HACKCLUBGANG/Per-Key-Rgb-Keyboard-Hotswap-FORGE/README.md

# Per-Key-Led-Keyboard-Hotswap-FORGE

Source Link Onshape -  https://cad.onshape.com/documents/a3706bff300e93766397b60f/w/be6071b581e0c225a171638b/e/79bd546bad59e5e5cdb5a4cd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
---------------------------------------
Render

Onshape


This is the Per-Key-Led-Keyboard-Hotswap which says in its name that it has per key ice blue led
It also has kailh hotswap attachment so u can also switch keys without worrying about opening the keyboard
Each key has a south facing smd ice blue led under the switch.


Heres A Render Of The Whole Build

https://github.com/user-attachments/assets/ba00d72b-443f-43d3-ab56-3a87e9c14a67

# Features 
- Per Key Rgb Customizable
- Hotswappable
- Compact  60%  10.1cm X 29.2 cm
- Usb C Powered
- 3d Printed Case
- Rp Pi Pico Fitted Into A Compact Keyboard
- 2 Layer Pcb
- Custom Made Led Circuitry
 Cool Looking :>

# Schematics 
Files in /PcbandSchem






#  Printed Circuit Board PCB
Files in /PcbandSchem

Front  Copper 

Back Copper

Both Layers


# Cad
Files in /CAD
Bottom   Plate

Top Plate

Both


# BOM
| # | Component | Part Number / Model | Qty Needed | Qty Purchased | Price (INR) | Product Link |
|---:|---|---|---:|---:|---:|---|
| 1 | Custom PCB + Shipping | JLCPCB FR-4 | 1 | 1 | ~2665 | [JLCPCB](https://jlcpcb.com/) |
| 2 | Microcontroller | Raspberry Pi Pico (RP2040) | 1 | 1 | 422 | [Robu](https://robu.in/) |
| 3 | USB-C Female Connector | Hroparts TYPE-C-31-M-13A (R250302) | 1 | 1 | 27 | [Robu](https://robu.in/product/type-c-31-m-13a-hroparts-5a-1-recessed-mount-16p-female-30%e2%84%8380-type-c-smd-usb-connectors-rohs/) |
| 4 | USB-A to Micro-USB Cable | 80cm | 1 | 1 | 59 | [Robu](https://robu.in/) |
| 5 | Micro-USB Male Connector | YT2153Y | 1 | 1 | 79 | [Robu](https://robu.in/) |
| 6 | LED Driver IC | TLC5948APWPR | 4 | 4 | 1144 | [Robu](https://robu.in/) |
| 7 | Ice-Blue LEDs | XINGLIGHT XL-2835BGWC-05 | 61 | 85 | 102 | [Robu](https://robu.in/) |
| 8 | Switching Diodes | Slkor 1N4148W SOD-123 | 61 | 70 | 72.80 | [Robu](https://robu.in/) |
| 9 | Ceramic Capacitors | 100nF, 1206, 50V | 4 | 4 | 32 | [Robu](https://robu.in/) |
| 10 | Bulk Capacitor | Taiyo Yuden EMK325ABJ107MM-T, 100µF 16V | 1 | 1 | 292.19* | [Taiyo Yuden](https://www.yuden.co.jp/) |
| 11 | Resistors | 10kΩ, 1206 | 4 | 12 | 10.56 | [Robu](https://robu.in/) |
| 12 | Resistors | 5.1kΩ, 1206 | 2 | 48 | 10.08 | [Robu](https://robu.in/) |
| 13 | Resistors | Yageo AC1206FR-07200RL, 200Ω | 0 required for IREF | 25 | 10.25 | [Robu](https://robu.in/) |
| 14 | Mechanical Switches | Gateron G Pro 3.0 Yellow | 61 | 70 (7 packs) | 1253.70 | [Meckeys](https://meckeys.com/) |
| 15 | Hot-Swap Sockets | Kailh MX Hot-Swap Socket, White | 61 | 7 listings | 504 | [Meckeys](https://meckeys.com/) |
| 16 | Stabilizers | DesignerStudio Plate Stabilizers | 4 × 2U + 1 × 6.25U | 1 kit | 550 | [Keyora](https://keyora.store/products/designerstudio-100-plate-mount-stabilizers-adaptive-wire-pom) |
| 17 | Keycaps | Selected keycap set | 1 set | 1 set | 799 | — |

## Notes
- Robu has a minimum order value of ₹10 per item.
- PCB + shipping is approximately $29 (₹2,665).
