HACKCLUBGANG/Per-Key-Rgb-Keyboard-Hotswap-FORGE/CAD/TopPlatwe.step

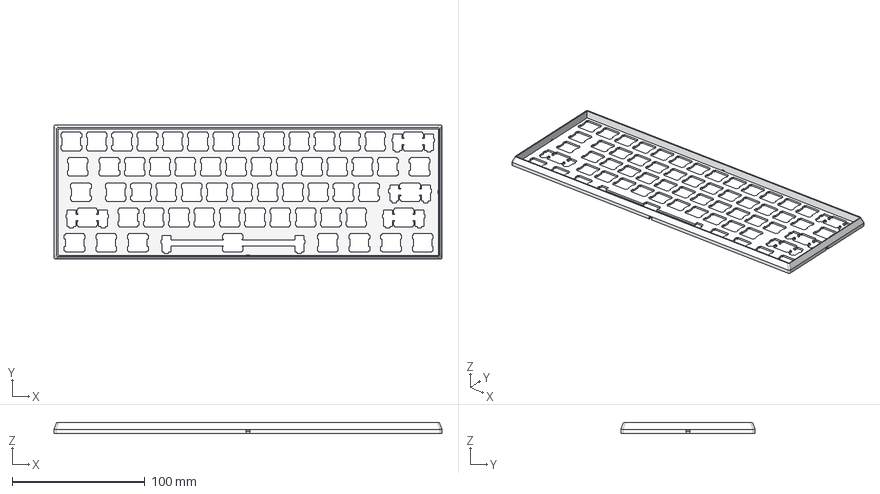
[picture p1: CAD file, 2026-11-12]
CAD/TopPlatwe.step
291.9 x 101.1 x 8.00 mm
