HACKCLUBGANG/Per-Key-Rgb-Keyboard-Hotswap-FORGE/CAD/BottomPlate.step

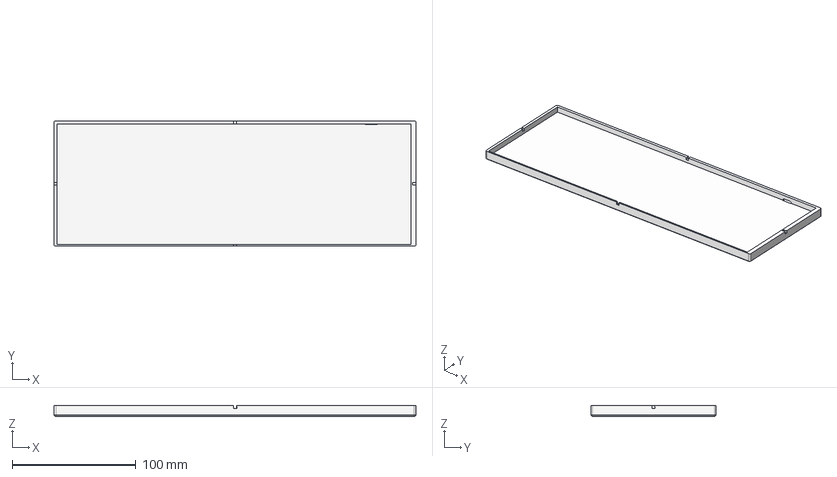
[picture p2: CAD file, 2026-11-12]
CAD/BottomPlate.step
291.9 x 101.1 x 8.50 mm
