HACKCLUBGANG/Per-Key-Rgb-Keyboard-Hotswap-FORGE/pcbandschem/keybaoard contour.kicad_pcb

## KiCad design pcbandschem/keybaoard contour.kicad_pcb (2026-11-12)

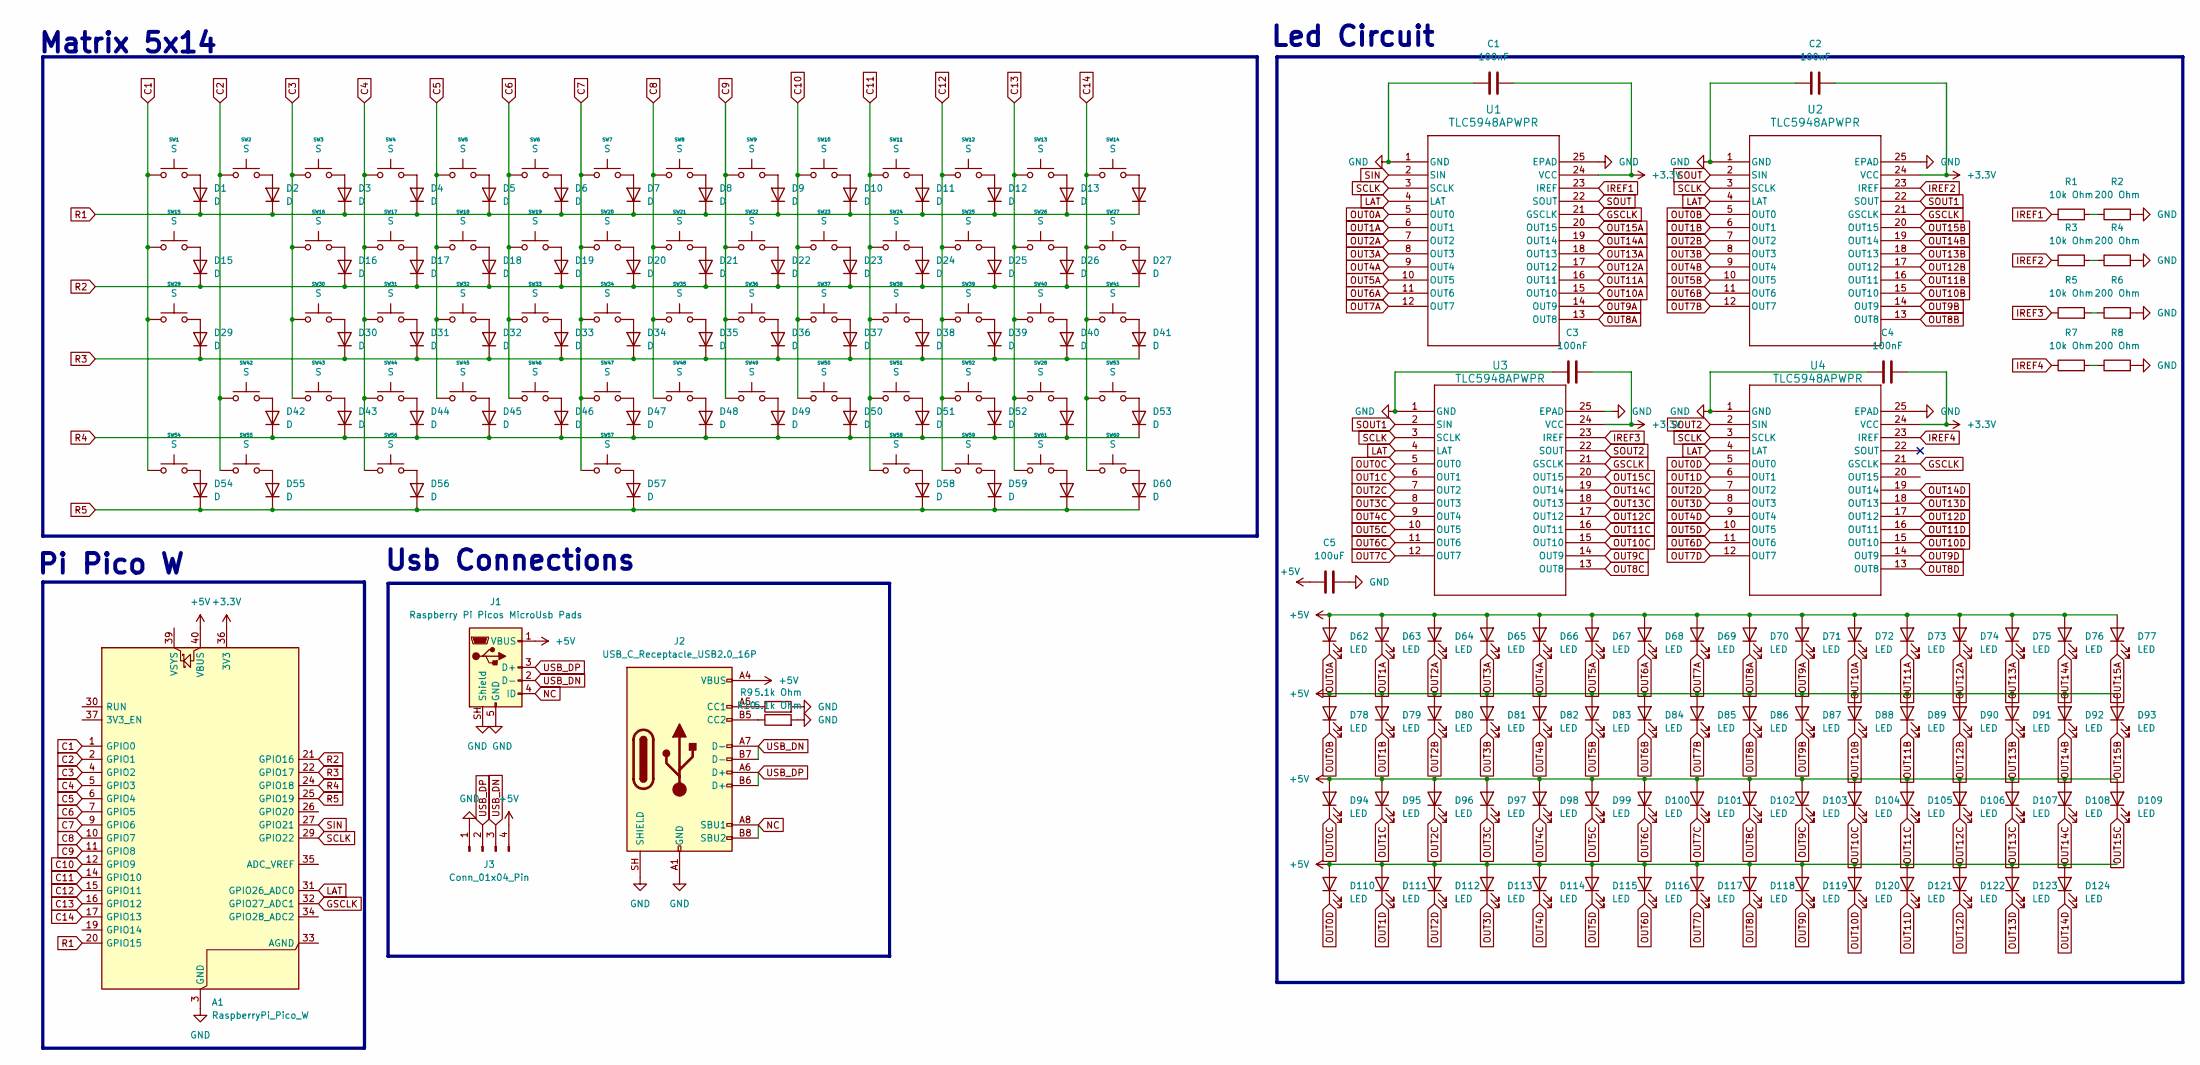
[picture p3: schematic keybaoard contour.kicad_sch]

Parts:
A1: RaspberryPi_Pico_W; RaspberryPi_Pico_SMD
C1, C2, C3, C4: 100nF; C_1206_3216Metric_Pad1.33x1.80mm_HandSolder
C5: 100uF; C_1210_3225Metric_Pad1.33x2.70mm_HandSolder
D1, D2, D3, D4, D5, D6, D7, D8, D9, D10, D11, D12, D13, D14, D15, D16, D17, D18, D19, D20, D21, D22, D23, D24, D25, D26, D27, D28, D29, D30, D31, D32, D33, D34, D35, D36, D37, D38, D39, D40, D41, D42, D43, D44, D45, D46, D47, D48, D49, D50, D51, D52, D53, D54, D55, D56, D57, D58, D59, D60, D61: D; D_SOD-123
D62, D63, D64, D65, D66, D67, D68, D69, D70, D71, D72, D73, D74, D75, D76, D77, D78, D79, D80, D81, D82, D83, D84, D85, D86, D87, D88, D89, D90, D91, D92, D93, D94, D95, D96, D97, D98, D99, D100, D101, D102, D103, D104, D105, D106, D107, D108, D109, D110, D111, D112, D113, D114, D115, D116, D117, D118, D119, D120, D121, D122, D123, D124: LED; LED_PLCC_2835_Handsoldering
J1: Raspberry Pi Picos MicroUsb Pads
J2: USB_C_Receptacle_USB2.0_16P; USB-C-SMD_TYPE-C-31-M-13C
J3: Conn_01x04_Pin; PinHeader_1x04_P2.54mm_Vertical
R1, R3, R5, R7: 10k Ohm; R_1206_3216Metric_Pad1.30x1.75mm_HandSolder
R2, R4, R6, R8: 200 Ohm; R_1206_3216Metric_Pad1.30x1.75mm_HandSolder
R9, R10: 5.1k Ohm; R_1206_3216Metric_Pad1.30x1.75mm_HandSolder
SW1, SW2, SW3, SW4, SW5, SW6, SW7, SW8, SW9, SW10, SW11, SW12, SW13, SW14, SW15, SW16, SW17, SW18, SW19, SW20, SW21, SW22, SW23, SW24, SW25, SW26, SW27, SW28, SW29, SW30, SW31, SW32, SW33, SW34, SW35, SW36, SW37, SW38, SW39, SW40, SW41, SW42, SW43, SW44, SW45, SW46, SW47, SW48, SW49, SW50, SW51, SW52, SW53, SW54, SW55, SW56, SW57, SW58, SW59, SW60, SW61: S; Kailh_socket_MX
U1, U2, U3, U4: TLC5948APWPR; PWP24_2P4X2P98_TEX

Connections:
+3.3V: A1.36 (3V3), C1.2, C2.2, C3.2, C4.2, U1.24 (VCC), U2.24 (VCC), U3.24 (VCC), U4.24 (VCC)
+5V: A1.40 (VBUS), C5.1, D62.2 (A), D63.2 (A), D64.2 (A), D65.2 (A), D66.2 (A), D67.2 (A), D68.2 (A), D69.2 (A), D70.2 (A), D71.2 (A), D72.2 (A), D73.2 (A), D74.2 (A), D75.2 (A), D76.2 (A), D77.2 (A), D78.2 (A), D79.2 (A), D80.2 (A), D81.2 (A), D82.2 (A), D83.2 (A), D84.2 (A), D85.2 (A), D86.2 (A), D87.2 (A), D88.2 (A), D89.2 (A), D90.2 (A), D91.2 (A), D92.2 (A), D93.2 (A), D94.2 (A), D95.2 (A), D96.2 (A), D97.2 (A), D98.2 (A), D99.2 (A), D100.2 (A), D101.2 (A), D102.2 (A), D103.2 (A), D104.2 (A), D105.2 (A), D106.2 (A), D107.2 (A), D108.2 (A), D109.2 (A), D110.2 (A), D111.2 (A), D112.2 (A), D113.2 (A), D114.2 (A), D115.2 (A), D116.2 (A), D117.2 (A), D118.2 (A), D119.2 (A), D120.2 (A), D121.2 (A), D122.2 (A), D123.2 (A), D124.2 (A), J1.1 (VBUS), J2.A4 (VBUS), J2.A9 (VBUS), J2.B4 (VBUS), J2.B9 (VBUS), J3.4
C1: A1.1 (GPIO0), SW1.1, SW15.1, SW29.1, SW54.1
C2: A1.2 (GPIO1), SW2.1, SW42.1, SW55.1
C3: A1.4 (GPIO2), SW3.1, SW16.1, SW30.1, SW43.1
C4: A1.5 (GPIO3), SW4.1, SW17.1, SW31.1, SW44.1, SW56.1
C5: A1.6 (GPIO4), SW5.1, SW18.1, SW32.1, SW45.1
C6: A1.7 (GPIO5), SW6.1, SW19.1, SW33.1, SW46.1
C7: A1.9 (GPIO6), SW7.1, SW20.1, SW34.1, SW47.1, SW57.1
C8: A1.10 (GPIO7), SW8.1, SW21.1, SW35.1, SW48.1
C9: A1.11 (GPIO8), SW9.1, SW22.1, SW36.1, SW49.1
C10: A1.12 (GPIO9), SW10.1, SW23.1, SW37.1, SW50.1
C11: A1.14 (GPIO10), SW11.1, SW24.1, SW38.1, SW51.1, SW58.1
C12: A1.15 (GPIO11), SW12.1, SW25.1, SW39.1, SW52.1, SW59.1
C13: A1.16 (GPIO12), SW13.1, SW26.1, SW28.1, SW40.1, SW61.1
C14: A1.17 (GPIO13), SW14.1, SW27.1, SW41.1, SW53.1, SW60.1
GND: A1.3 (GND), A1.8 (GND), A1.13 (GND), A1.18 (GND), A1.23 (GND), A1.28 (GND), A1.38 (GND), C1.1, C2.1, C3.1, C4.1, C5.2, J1.5 (GND), J1.SH (Shield), J2.A1 (GND), J2.A12 (GND), J2.B1 (GND), J2.B12 (GND), J2.SH (SHIELD), J3.1, R2.2, R4.2, R6.2, R8.2, R9.2, R10.2, U1.1 (GND), U1.25 (EPAD), U2.1 (GND), U2.25 (EPAD), U3.1 (GND), U3.25 (EPAD), U4.1 (GND), U4.25 (EPAD)
GSCLK: A1.32 (GPIO27_ADC1), U1.21 (GSCLK), U2.21 (GSCLK), U3.21 (GSCLK), U4.21 (GSCLK)
IREF1: R1.1, U1.23 (IREF)
IREF2: R3.1, U2.23 (IREF)
IREF3: R5.1, U3.23 (IREF)
IREF4: R7.1, U4.23 (IREF)
LAT: A1.31 (GPIO26_ADC0), U1.4 (LAT), U2.4 (LAT), U3.4 (LAT), U4.4 (LAT)
NC: J1.4 (ID), J2.A8 (SBU1), J2.B8 (SBU2)
unnamed: D1.2 (A), SW1.2
unnamed: D2.2 (A), SW2.2
unnamed: D3.2 (A), SW3.2
unnamed: D4.2 (A), SW4.2
unnamed: D5.2 (A), SW5.2
unnamed: D6.2 (A), SW6.2
unnamed: D7.2 (A), SW7.2
unnamed: D8.2 (A), SW8.2
unnamed: D9.2 (A), SW9.2
unnamed: D10.2 (A), SW10.2
unnamed: D11.2 (A), SW11.2
unnamed: D12.2 (A), SW12.2
unnamed: D13.2 (A), SW13.2
unnamed: D14.2 (A), SW14.2
unnamed: D15.2 (A), SW15.2
unnamed: D16.2 (A), SW16.2
unnamed: D17.2 (A), SW17.2
unnamed: D18.2 (A), SW18.2
unnamed: D19.2 (A), SW19.2
unnamed: D20.2 (A), SW20.2
unnamed: D21.2 (A), SW21.2
unnamed: D22.2 (A), SW22.2
unnamed: D23.2 (A), SW23.2
unnamed: D24.2 (A), SW24.2
unnamed: D25.2 (A), SW25.2
unnamed: D26.2 (A), SW26.2
unnamed: D27.2 (A), SW27.2
unnamed: D28.2 (A), SW28.2
unnamed: D29.2 (A), SW29.2
unnamed: D30.2 (A), SW30.2
unnamed: D31.2 (A), SW31.2
unnamed: D32.2 (A), SW32.2
unnamed: D33.2 (A), SW33.2
unnamed: D34.2 (A), SW34.2
unnamed: D35.2 (A), SW35.2
unnamed: D36.2 (A), SW36.2
unnamed: D37.2 (A), SW37.2
unnamed: D38.2 (A), SW38.2
unnamed: D39.2 (A), SW39.2
unnamed: D40.2 (A), SW40.2
unnamed: D41.2 (A), SW41.2
unnamed: D42.2 (A), SW42.2
unnamed: D43.2 (A), SW43.2
unnamed: D44.2 (A), SW44.2
unnamed: D45.2 (A), SW45.2
unnamed: D46.2 (A), SW46.2
unnamed: D47.2 (A), SW47.2
unnamed: D48.2 (A), SW48.2
unnamed: D49.2 (A), SW49.2
unnamed: D50.2 (A), SW50.2
unnamed: D51.2 (A), SW51.2
unnamed: D52.2 (A), SW52.2
unnamed: D53.2 (A), SW53.2
unnamed: D54.2 (A), SW54.2
unnamed: D55.2 (A), SW55.2
unnamed: D56.2 (A), SW56.2
unnamed: D57.2 (A), SW57.2
unnamed: D58.2 (A), SW58.2
unnamed: D59.2 (A), SW59.2
unnamed: D60.2 (A), SW60.2
unnamed: D61.2 (A), SW61.2
unnamed: J2.A5 (CC1), R9.1
unnamed: J2.B5 (CC2), R10.1
unnamed: R1.2, R2.1
unnamed: R3.2, R4.1
unnamed: R5.2, R6.1
unnamed: R7.2, R8.1
OUT0A: D62.1 (K), U1.5 (OUT0)
OUT0B: D78.1 (K), U2.5 (OUT0)
OUT0C: D94.1 (K), U3.5 (OUT0)
OUT0D: D110.1 (K), U4.5 (OUT0)
OUT1A: D63.1 (K), U1.6 (OUT1)
OUT1B: D79.1 (K), U2.6 (OUT1)
OUT1C: D95.1 (K), U3.6 (OUT1)
OUT1D: D111.1 (K), U4.6 (OUT1)
OUT2A: D64.1 (K), U1.7 (OUT2)
OUT2B: D80.1 (K), U2.7 (OUT2)
OUT2C: D96.1 (K), U3.7 (OUT2)
OUT2D: D112.1 (K), U4.7 (OUT2)
OUT3A: D65.1 (K), U1.8 (OUT3)
OUT3B: D81.1 (K), U2.8 (OUT3)
OUT3C: D97.1 (K), U3.8 (OUT3)
OUT3D: D113.1 (K), U4.8 (OUT3)
OUT4A: D66.1 (K), U1.9 (OUT4)
OUT4B: D82.1 (K), U2.9 (OUT4)
OUT4C: D98.1 (K), U3.9 (OUT4)
OUT4D: D114.1 (K), U4.9 (OUT4)
OUT5A: D67.1 (K), U1.10 (OUT5)
OUT5B: D83.1 (K), U2.10 (OUT5)
OUT5C: D99.1 (K), U3.10 (OUT5)
OUT5D: D115.1 (K), U4.10 (OUT5)
OUT6A: D68.1 (K), U1.11 (OUT6)
OUT6B: D84.1 (K), U2.11 (OUT6)
OUT6C: D100.1 (K), U3.11 (OUT6)
OUT6D: D116.1 (K), U4.11 (OUT6)
OUT7A: D69.1 (K), U1.12 (OUT7)
OUT7B: D85.1 (K), U2.12 (OUT7)
OUT7C: D101.1 (K), U3.12 (OUT7)
OUT7D: D117.1 (K), U4.12 (OUT7)
OUT8A: D70.1 (K), U1.13 (OUT8)
OUT8B: D86.1 (K), U2.13 (OUT8)
OUT8C: D102.1 (K), U3.13 (OUT8)
OUT8D: D118.1 (K), U4.13 (OUT8)
OUT9A: D71.1 (K), U1.14 (OUT9)
OUT9B: D87.1 (K), U2.14 (OUT9)
OUT9C: D103.1 (K), U3.14 (OUT9)
OUT9D: D119.1 (K), U4.14 (OUT9)
OUT10A: D72.1 (K), U1.15 (OUT10)
OUT10B: D88.1 (K), U2.15 (OUT10)
OUT10C: D104.1 (K), U3.15 (OUT10)
OUT10D: D120.1 (K), U4.15 (OUT10)
OUT11A: D73.1 (K), U1.16 (OUT11)
OUT11B: D89.1 (K), U2.16 (OUT11)
OUT11C: D105.1 (K), U3.16 (OUT11)
OUT11D: D121.1 (K), U4.16 (OUT11)
OUT12A: D74.1 (K), U1.17 (OUT12)
OUT12B: D90.1 (K), U2.17 (OUT12)
OUT12C: D106.1 (K), U3.17 (OUT12)
OUT12D: D122.1 (K), U4.17 (OUT12)
OUT13A: D75.1 (K), U1.18 (OUT13)
OUT13B: D91.1 (K), U2.18 (OUT13)
OUT13C: D107.1 (K), U3.18 (OUT13)
OUT13D: D123.1 (K), U4.18 (OUT13)
OUT14A: D76.1 (K), U1.19 (OUT14)
OUT14B: D92.1 (K), U2.19 (OUT14)
OUT14C: D108.1 (K), U3.19 (OUT14)
OUT14D: D124.1 (K), U4.19 (OUT14)
OUT15A: D77.1 (K), U1.20 (OUT15)
OUT15B: D93.1 (K), U2.20 (OUT15)
OUT15C: D109.1 (K), U3.20 (OUT15)
R1: A1.20 (GPIO15), D1.1 (K), D2.1 (K), D3.1 (K), D4.1 (K), D5.1 (K), D6.1 (K), D7.1 (K), D8.1 (K), D9.1 (K), D10.1 (K), D11.1 (K), D12.1 (K), D13.1 (K), D14.1 (K)
R2: A1.21 (GPIO16), D15.1 (K), D16.1 (K), D17.1 (K), D18.1 (K), D19.1 (K), D20.1 (K), D21.1 (K), D22.1 (K), D23.1 (K), D24.1 (K), D25.1 (K), D26.1 (K), D27.1 (K)
R3: A1.22 (GPIO17), D29.1 (K), D30.1 (K), D31.1 (K), D32.1 (K), D33.1 (K), D34.1 (K), D35.1 (K), D36.1 (K), D37.1 (K), D38.1 (K), D39.1 (K), D40.1 (K), D41.1 (K)
R4: A1.24 (GPIO18), D28.1 (K), D42.1 (K), D43.1 (K), D44.1 (K), D45.1 (K), D46.1 (K), D47.1 (K), D48.1 (K), D49.1 (K), D50.1 (K), D51.1 (K), D52.1 (K), D53.1 (K)
R5: A1.25 (GPIO19), D54.1 (K), D55.1 (K), D56.1 (K), D57.1 (K), D58.1 (K), D59.1 (K), D60.1 (K), D61.1 (K)
SCLK: A1.29 (GPIO22), U1.3 (SCLK), U2.3 (SCLK), U3.3 (SCLK), U4.3 (SCLK)
SIN: A1.27 (GPIO21), U1.2 (SIN)
SOUT: U1.22 (SOUT), U2.2 (SIN)
SOUT1: U2.22 (SOUT), U3.2 (SIN)
SOUT2: U3.22 (SOUT), U4.2 (SIN)
USB_DN: J1.2 (D-), J2.A7 (D-), J2.B7 (D-), J3.3
USB_DP: J1.3 (D+), J2.A6 (D+), J2.B6 (D+), J3.2

Notes on the sheet:
Led Circuit
Matrix 5x14
Pi Pico W
Usb Connections

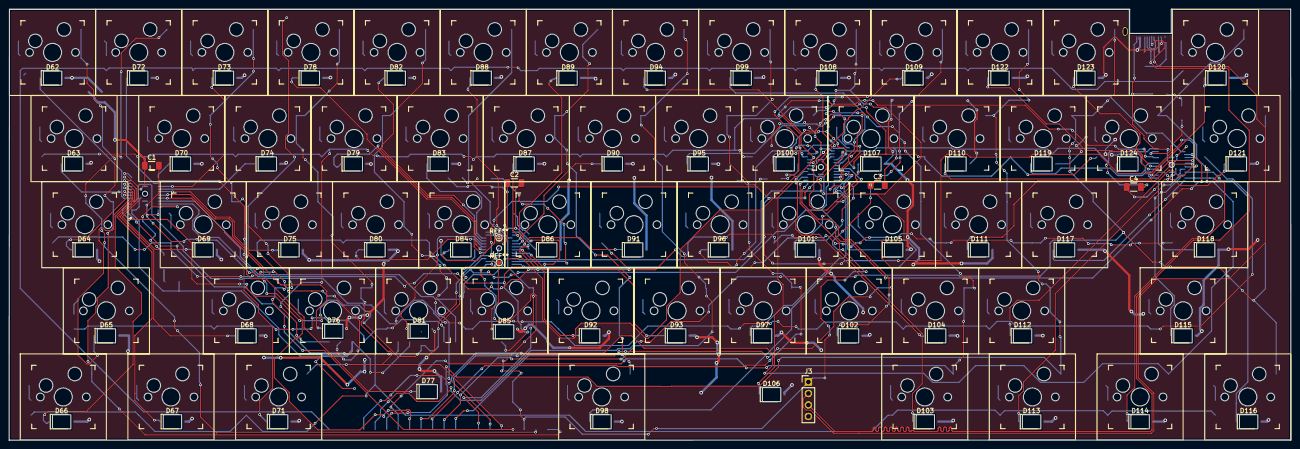
[picture p4: board keybaoard contour.kicad_pcb from above]

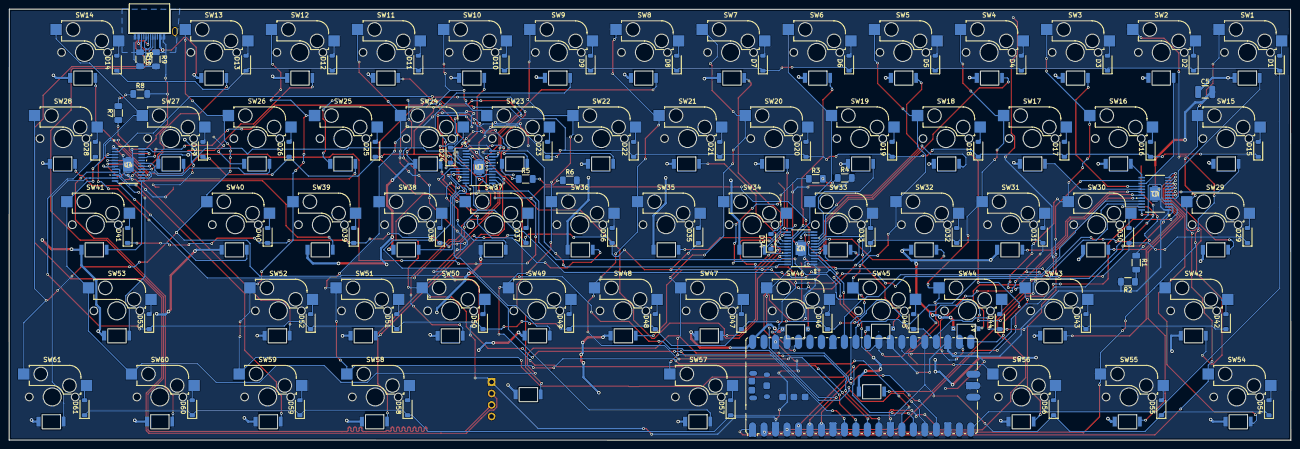
[picture p5: board keybaoard contour.kicad_pcb from below]

Board: 2 copper layers, 283.4 x 95.3 mm, 207 parts (78 on the bottom side), 166 nets.
