HACKCLUBGANG/Per-Key-Rgb-Keyboard-Hotswap-FORGE/(commit log)

2026-11-12 Create CAD
2026-11-12 Update and rename del to Assembly
